AYUSH-pro-grammer/poromodo/bom.csv

Name | Quantity | Unit price (USD) | Total (USD) | URL to buy
XIAO ESP32-C3 (U1) | 1 | 5.39 | 5.39 | https://www.robotshop.com/products/seeedstudio-xiao-esp32c3-tiny-mcu-w-wi-fi-ble
AP63205WU-7 buck converter, 5V 2A, TSOT-26 (U2) | 1 | 0.25 | 0.25 | https://www.lcsc.com/product-detail/C2071056.html
Inductor 4.7uH, Bourns SRN6045TA-4R7M (L1) | 1 | 0.60 | 0.60 | https://www.digikey.fi/en/products/detail/bourns-inc/SRN6045TA-4R7M/6155104
Capacitor 22uF 25V X5R 1206 (C1, C2) | 2 | 0.0595 | 0.12 | https://www.lcsc.com/product-detail/C12891.html
Capacitor 10uF 1206 (C4) | 1 | 0.05 | 0.05 | https://www.lcsc.com/search?q=10uF+1206+25V+X5R
Capacitor 100nF 0805 (C3, C5) | 2 | 0.01 | 0.02 | https://www.lcsc.com/search?q=100nF+0805+50V
Resistor 1k 0805 (R1) | 1 | 0.01 | 0.01 | https://www.lcsc.com/search?q=1k+0805+resistor
Resistor 100k 0805 (R2, battery divider top) | 1 | 0.01 | 0.01 | https://www.lcsc.com/search?q=100k+0805+resistor
Resistor 33k 0805 (R3, battery divider bottom) | 1 | 0.01 | 0.01 | https://www.lcsc.com/search?q=33k+0805+resistor
Resistor 470 ohm 0805 (R4) | 1 | 0.01 | 0.01 | https://www.lcsc.com/search?q=470+ohm+0805+resistor
Schottky diode SS34, SMA (D2) | 1 | 0.05 | 0.05 | https://www.lcsc.com/search?q=SS34
Diode 1N4148W, SOD-123 (D1, buzzer flyback) | 1 | 0.02 | 0.02 | https://www.lcsc.com/search?q=1N4148W
LED 0805 (D3) | 1 | 0.03 | 0.03 | https://www.lcsc.com/search?q=led+0805
NPN transistor MMBT3904, SOT-23 (Q1) | 1 | 0.02 | 0.02 | https://www.lcsc.com/search?q=MMBT3904
P-MOSFET AO3401A, SOT-23 (Q2) | 1 | 0.10 | 0.10 | https://www.lcsc.com/search?q=AO3401A
Passive buzzer 12x9.5 mm, Soberton WT-1209T (BZ1) | 1 | 1.15 | 1.15 | https://www.digikey.com/en/products/detail/soberton-inc/WT-1209T/16384509
GY-521 MPU6050 module (J4 socket) | 1 | 3.79 | 3.79 | https://openelab.com/products/mpu6050-gy521-six-axis-sensor
0.96 inch OLED 128x64 I2C SSD1306, 4 pin (J1 socket) | 1 | 6.89 | 6.89 | https://shillehtek.com/products/0-96-i2c-white-oled-display-module-4-pin-ssd1306
Female pin socket 1x8, 2.54 mm (J4) | 1 | 0.15 | 0.15 | https://www.lcsc.com/search?q=female+header+1x8+2.54
Female pin socket 1x4, 2.54 mm (J1) | 1 | 0.10 | 0.10 | https://www.lcsc.com/search?q=female+header+1x4+2.54
Male pin header 1x2, 2.54 mm (SW2 footprint) | 1 | 0.05 | 0.05 | https://www.lcsc.com/search?q=pin+header+1x2+2.54
Slide or rocker switch SPST, to wire to SW2 | 1 | 0.50 | 0.50 | https://www.lcsc.com/search?q=slide+switch+SPDT
Tactile switch 6x6 mm through hole (SW1, SW3) | 2 | 0.017 | 0.03 | https://www.lcsc.com/product-detail/C480288.html
JST PH 2-pin header B2B-PH-K-S (J2) | 1 | 0.30 | 0.30 | https://www.digikey.nl/en/products/detail/jst-sales-america-inc/B2B-PH-K-S/926611
2S Li-ion battery pack 7.4V with JST PH 2.0 plug | 1 | 9.00 | 9.00 | https://www.digikey.com/en/search?keywords=7.4V%20li-ion%20battery%20pack%20JST%20PH
M3 screws and standoffs (4 sets) | 1 | 1.50 | 1.50 | https://www.lcsc.com/search?q=M3+standoff
PCB, 2 layer, 36x82 mm, 1.6 mm, green (5 pieces) | 1 | 4.00 | 4.00 | https://jlcpcb.com/
PCB shipping, UPS Express Saver (2-4 business days) | 1 | 26.60 | 26.60 | https://jlcpcb.com/
TOTAL | 31 |  | 60.75
