AYUSH-pro-grammer/poromodo/3d/poromodo-printable-p2.stl

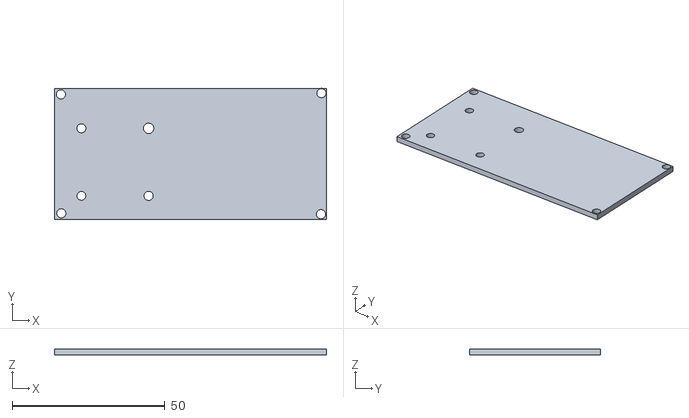
[picture p8: CAD file, 2026-11-09]
3d/poromodo-printable-p2.stl
89.0 x 43.0 x 2.00
