AYUSH-pro-grammer/poromodo/3d/poromodo.step

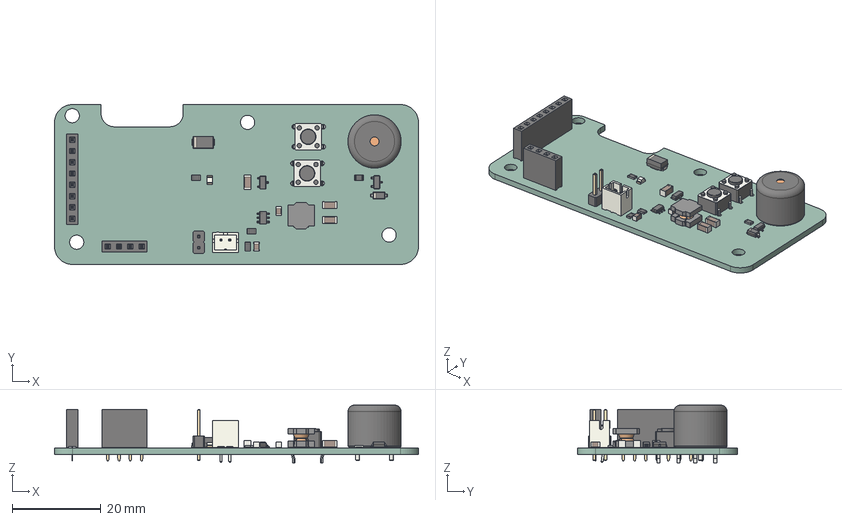
[picture p9: CAD file, 2026-11-09]
3d/poromodo.step
82.0 x 36.0 x 13.0 mm
D_SMA
R_0805_2012Metric x 4
C_0805_2012Metric x 2
LED_0805_2012Metric
SOT-23 x 2
L_Bourns_SRN6045TA
TSOT-23-6
PinSocket_1x08_P2.54mm_Vertical
PinSocket_1x04_P2.54mm_Vertical
D_SOD-123
C_1206_3216Metric x 3
SW_PUSH_6mm x 2
PinHeader_1x02_P254mm_Vertical
JST_B2B_PH_K
Buzzer_12x95RM76
Untitled-unsaved-export-ygYcFu_PCB
