AYUSH-pro-grammer/poromodo/3d/poromodo-printable-p1.stl

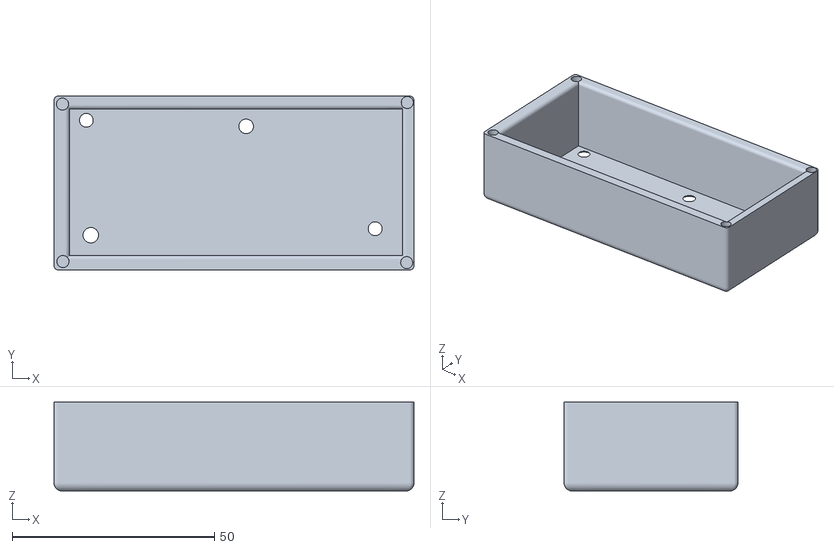
[picture p10: CAD file, 2026-11-09]
3d/poromodo-printable-p1.stl
89.0 x 43.0 x 22.0
