AYUSH-pro-grammer/poromodo/(list of files, cad)

Other CAD files:
3d/poromodo-assembled.f3z
