AYUSH-pro-grammer/poromodo/kicad/Untitled/poromodo.kicad_pcb

## KiCad design kicad/Untitled/poromodo.kicad_pcb (2026-11-09)

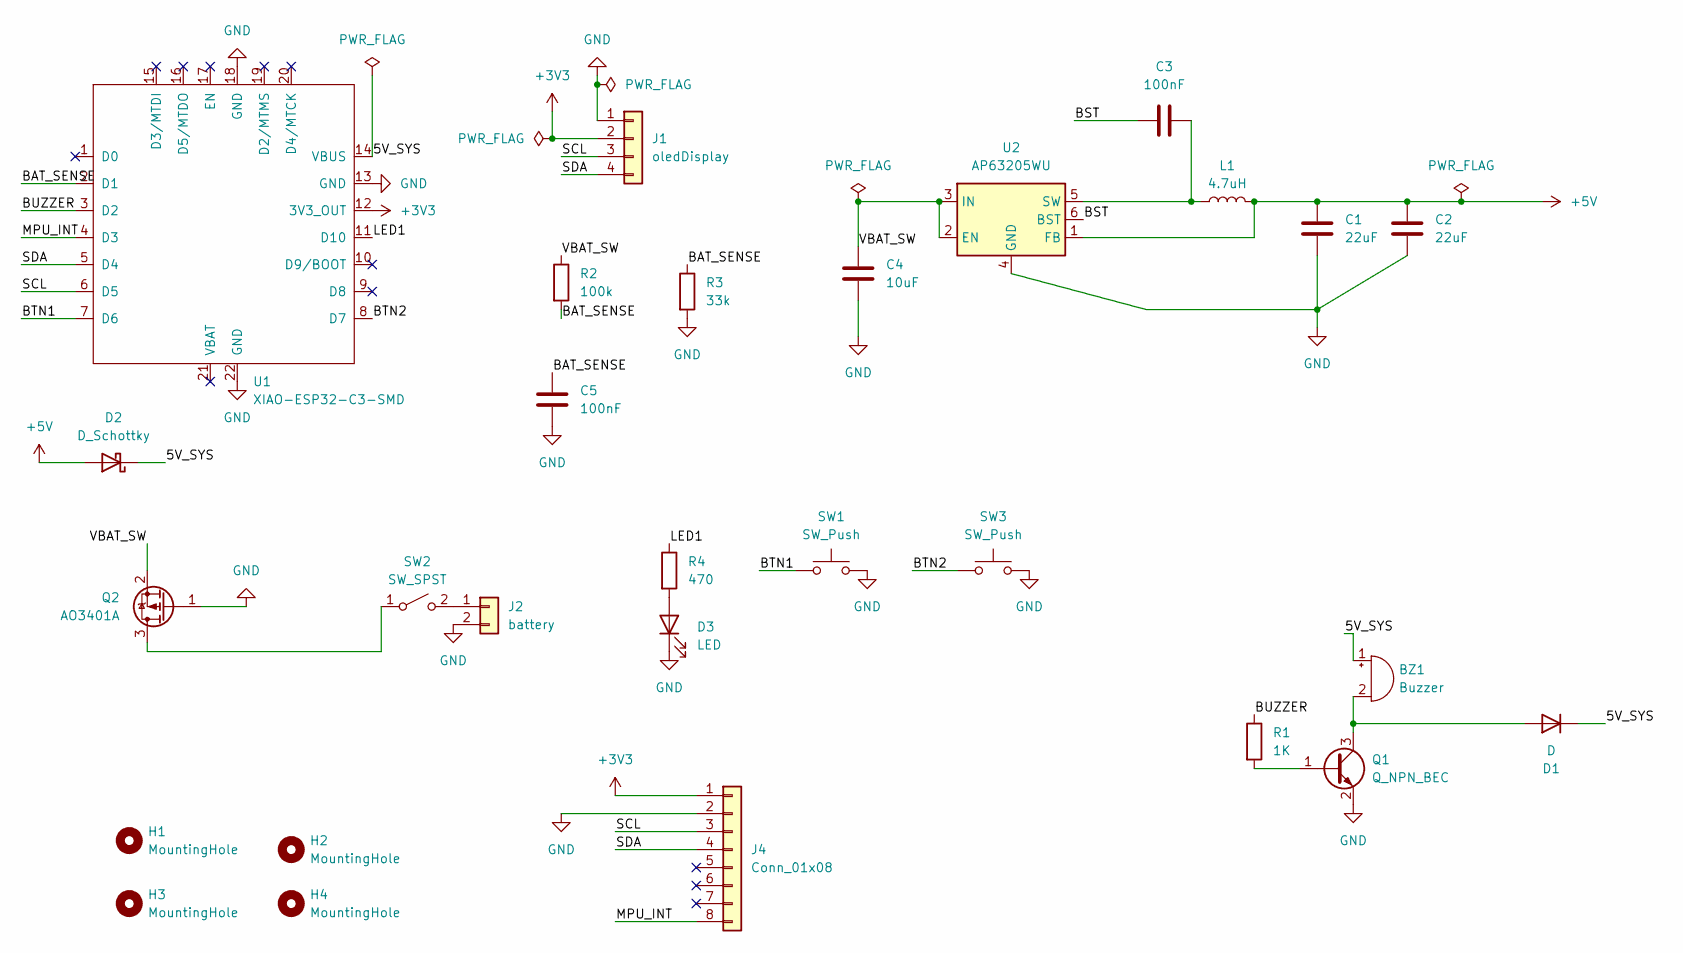
[picture p87: schematic poromodo.kicad_sch]

Parts:
BZ1: Buzzer; Buzzer_12x9.5RM7.6
C1, C2: 22uF; C_1206_3216Metric
C3, C5: 100nF; C_0805_2012Metric
C4: 10uF; C_1206_3216Metric
D1: D; D_SOD-123
D2: D_Schottky; D_SMA
D3: LED; LED_0805_2012Metric
H1, H2, H3, H4: MountingHole; MountingHole_3.2mm_M3
J1: oledDisplay; PinSocket_1x04_P2.54mm_Vertical
J2: battery; JST_PH_B2B-PH-K_1x02_P2.00mm_Vertical
J4: Conn_01x08; PinSocket_1x08_P2.54mm_Vertical
L1: 4.7uH; L_Bourns_SRN6045TA
Q1: Q_NPN_BEC; SOT-23
Q2: AO3401A; SOT-23
R1: 1K; R_0805_2012Metric
R2: 100k; R_0805_2012Metric
R3: 33k; R_0805_2012Metric
R4: 470; R_0805_2012Metric
SW1, SW3: SW_Push; SW_PUSH_6mm
SW2: SW_SPST; PinHeader_1x02_P2.54mm_Vertical
U1: XIAO-ESP32-C3-SMD
U2: AP63205WU; TSOT-23-6

Connections:
+3V3: J1.2, J4.1, U1.12 (3V3_OUT)
+5V: C1.1, C2.1, D2.2 (A), L1.2, U2.1 (FB)
/5V_SYS: BZ1.1 (+), D1.1 (K), D2.1 (K), U1.14 (VBUS)
/BAT_SENSE: C5.1, R2.2, R3.1, U1.2 (D1)
/BST: C3.1, U2.6 (BST)
/BTN1: SW1.1, U1.7 (D6)
/BTN2: SW3.1, U1.8 (D7)
/BUZZER: R1.1, U1.3 (D2)
/LED1: R4.1, U1.11 (D10)
/MPU_INT: J4.8, U1.4 (D3)
/SCL: J1.3, J4.3, U1.6 (D5)
/SDA: J1.4, J4.4, U1.5 (D4)
/VBAT_SW: C4.1, Q2.2 (S), R2.1, U2.2 (EN), U2.3 (IN)
GND: C1.2, C2.2, C4.2, C5.2, D3.1 (K), J1.1, J2.2, J4.2, Q1.2 (E), Q2.1 (G), R3.2, SW1.2, SW3.2, U1.13 (GND), U1.18 (GND), U1.22 (GND), U2.4 (GND)
unnamed: BZ1.2 (-), D1.2 (A), Q1.3 (C)
unnamed: D3.2 (A), R4.2
unnamed: J2.1, SW2.2 (B)
unnamed: Q1.1 (B), R1.2
unnamed: Q2.3 (D), SW2.1 (A)
unnamed: C3.2, L1.1, U2.5 (SW)

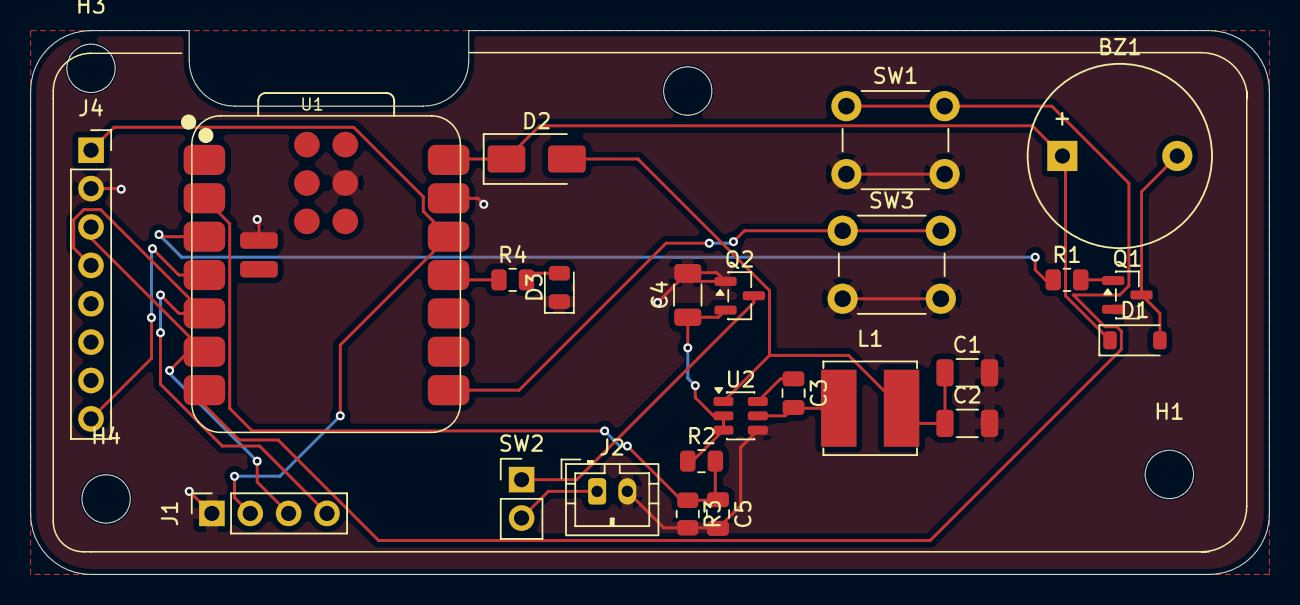
[picture p88: board poromodo.kicad_pcb from above]

Board: 2 copper layers, 82.0 x 36.0 mm, 28 parts (0 on the bottom side), 20 nets.
