AYUSH-pro-grammer/poromodo/(commit log)

2026-11-09 Add PCB design, Gerbers and CAD models
    [Untitled-B_Cu.gbr, Untitled-B_Mask.gbr, Untitled-B_Paste.gbr, Untitled-B_Silkscreen.gbr, Untitled-Edge_Cuts.gbr, Untitled-F_Cu.gbr, Untitled-F_Mask.gbr, Untitled-F_Paste.gbr]
2026-11-09 Add README, BOM and project images
    [bom.csv]
